hologram94/3DOF-RoboticArm-SPG30E/GUI using keuwlsoft app/readme.txt

1. Install the apk
2. Import the Training_GUI.kwl into the app
3. Connect to the device through bluetooth or USB.
4. Run the GUI panel.
