hologram94/3DOF-RoboticArm-SPG30E/SPG30E Motor References/README_Motor.md

###### Refences for SPG30E Motor

### Description
The motors that were used was obtained from cytron.io. The motor dimensions can be used as a refence if anyone want to tweak the design.
https://my.cytron.io/p-12v-75rpm-3kgfcm-brushed-dc-geared-motor-with-encoder
