hologram94/3DOF-RoboticArm-SPG30E/Calculation/ROBOTIC PROJECT CALCULATION.pdf

D-H PARAMETERS TABLE

FORWARD KINEMATIC

To get the forward kinematic solution, Denavit-Hartenberg (D-H) representation is applied. The D-H model of representation is a very simple way of modeling robot links and joints that any robot configuration such as articulated robot configuration that proposed in this project, regardless of its sequence or complexity. To model the robot with the D-H representation, initially assign a local reference frame for each and every joint. Then determine the following parameters :

- θ , represented a rotation about z-axis.
- d , represented the distance on the z-axis between two successive common normal,
- a , represented the length of each common normal, also defined as length of a link,
joint | αi | i a | i d | θi
1 | 90o | 0 | L1 | θ1
2 | 0o | 0 | 0 | θ2
3 | 0o | L2 | 0 | θ3
4 | 0o | L3 | 0 | 0

- α , represented the angle between two successive z
axes, also defined as joint twist angle.

Transformation nTn+1 between two successive frames representing the preceding four movement is the product of four basic homogeneous transformation matrices (revolute joints) representing them. The final formula of revolute joints is as shown below:

The final formula of revolution matrix

−

−
= −
0 | 0 | 0 | 1

0

1

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

i
α | α
θ | θ α | θ α θ
θ | θ α | θ α | θ

Substitute the parameters in D-H Table into the matrix form above to get the matrices for , , , . ³
4

2
3

1
2

0
1

T T T T

Homogeneous transform matrices

− =

0 0 0 1

0 1 0

0 | 0
0 | 0

1

0

| 1
1 | 1
1 | 1

L

s | c
c | s
T

- −

=
0 | 0 0 1
0 | 0 1 0 0 0 0 0

2

1 | 2 | 2
2 | 2
s | c
c | s
T

- −

=
0 0 0 1

0 0 1 0

0

0

3

2 | 3 | 3 | 2 3
3 | 3 | 2 3
| s | c | L s
c | s | L c
T

=
0 0 0 1

0 0 1 0

0 1 0 0

1 0 0

4

3

L3
T

Where i c is the cosine of the angleθi , and i s represent the sine.

By multiplying the homogeneous transformation matrices in the right order, T

0
4
describing the end-effector frame with the reference frame may be obtained.

T T T T T

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
− | + | + | +
− | − | − | − | + | − | −
− | − | − | + | − | −

=
0 | 0 | 0 | 1
23 23 | 23 | 23 | 0 | 2 3 3 | 2 3 2 | 3 2 3 | 1
1 23 | 1 23 | 2 13 | 3 12 | 1 | 1 23 2 | 1 23 3 | 1 23 2 | 1 23 3
1 23 | 1 23 | 12 3 | 13 2 | 1 | 1 23 2 | 1 23 3 | 1 23 2 | 1 23 3

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

INVERSE KINEMATIC

=
0 0 0 1

0
M N B z

M N B y

M N B x
T
y | y | y
y | y | y
x | x | x
H | (1-2)

By comparing Eq. (1-1) anf Eq. (1-2)

2 3 3 | 2 3 2 | 3 2 3 | 1
1 23 2 | 1 23 3 | 1 23 2 | 1 23 3
1 23 2 | 1 23 3 | 1 23 2 | 1 23 3

z c s L c s L c s L L

y s c L s c L s s L s s L

x c c L c c L c s L c s L

= | + | + | +
= | + | − | −
= | + | − | −
(Assumed)
( | )
( | )

1
1

1

1 23 2 | 23 3 | 23 2 | 23 3
1 23 2 | 23 3 | 23 2 | 23 3
1 23 2 | 1 23 3 | 1 23 2 | 1 23 3
1 23 2 | 1 23 3 | 1 23 2 | 1 23 3

= = tanθ

+ | − | −
+ | − | − =
+ | − | −
+ | − | − =

c

s

c c L c L s L s L

s c L c L s L s L

c c L c c L c s L c s L

s c L s c L s s L s s L
x

y

- = | x
y θ1 | a tan 2 | (1-3)

23
23

23 = = tanθ
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
θ 23 | a tan 2 | (1-4)

3 3

2 3 3 | 2 3 2 | 1
2
2 3 3 | 2 3 2 | 3 2 3 | 1

c L

z c s L c s L L
s

z c s L c s L c s L L

− | − | − =
= | + | + | +
(1-5)
( | ) 1 23 2 | 23 3 | 23 2 | 23 3
1 23 2 | 1 23 3 | 1 23 2 | 1 23 3

x c c L c L s L s L

x c c L c c L c s L c s L

= | + | − | −
= | + | − | −
3 2 | 3 3
23 2 | 23 3
1
2
c L c L

s L s L
c

x
c
+
+ | +
= | (1-6)

From Eq. (1-5) and Eq. (1-6)

+

+ | +
− | − | −
=

−

− | −
= | =
3 2 | 3 3
23 2 | 23 3
1

3 3

2 3 3 | 2 3 2 | 1

2

2

23 3
1

2

23 3 1

2
2

2

tan 2

tan

c L c L

s L s L
c

x

c L

z c s L c s L L
a

L

c L
c

x

L

z s L L

c

s

θ

θ

From Eq. assumed

Summing up squares of x y z

( | ) ( | )

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
2 | 2 | 2
3 | 2

2
L L
x y z | L L | L | L z L
c
+ + − | + | + | − | − = | (1-7)

From pythagorean trigonometric

3 | 1 3 s = ± − c | (1-8)

From Eq. (1-7) and Eq. (1-8)

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
tan 2

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
