hologram94/3DOF-RoboticArm-SPG30E/GUI using keuwlsoft app/GUI_Screenshot.jpg

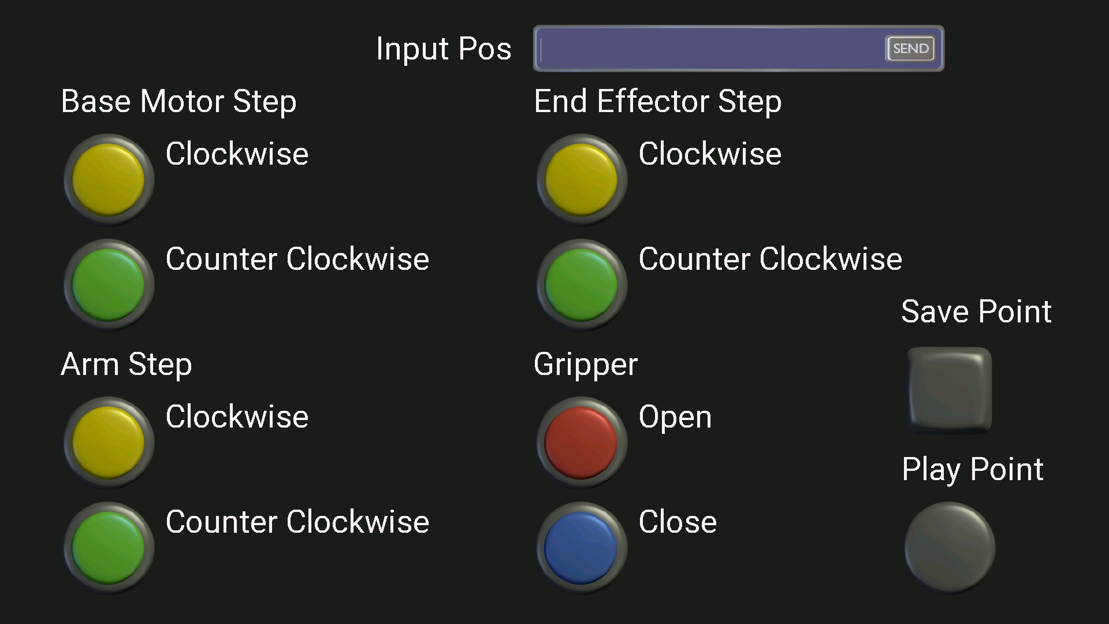
GUI using keuwlsoft app/GUI_Screenshot.jpg
