hologram94/3DOF-RoboticArm-SPG30E/Servo Gripper STL and Coding/stl/Mount.stl

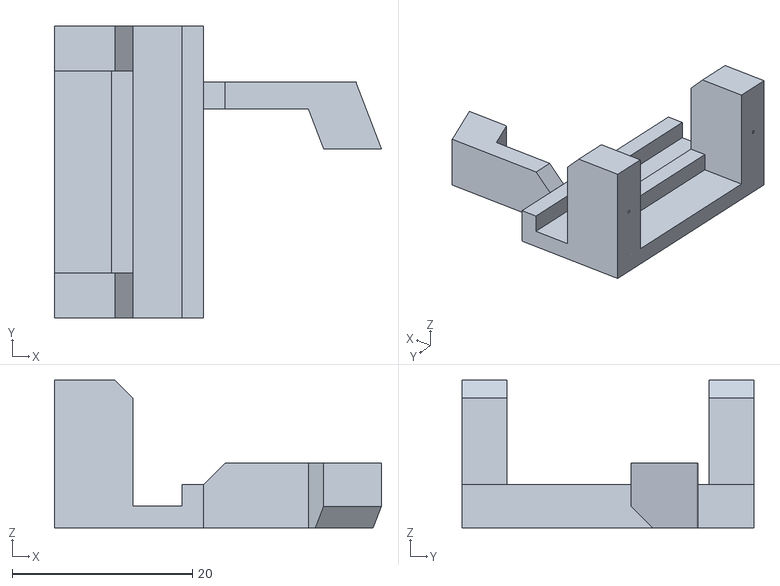
[picture p3: CAD file, 2019-12-25]
Servo Gripper STL and Coding/stl/Mount.stl
36.3 x 32.4 x 16.4
