hologram94/3DOF-RoboticArm-SPG30E/STL Files and Drawing/Arm/Arm.stl

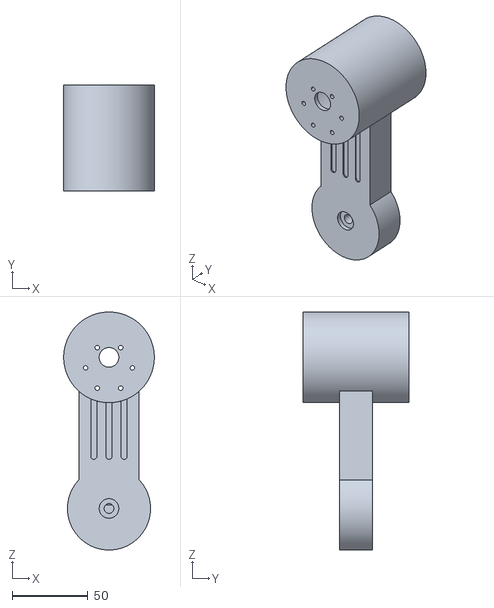
[picture p4: CAD file, 2019-12-24]
STL Files and Drawing/Arm/Arm.stl
60.0 x 70.0 x 157.5
