hologram94/3DOF-RoboticArm-SPG30E/STL Files and Drawing/Base Arm/Base_Arm.stl

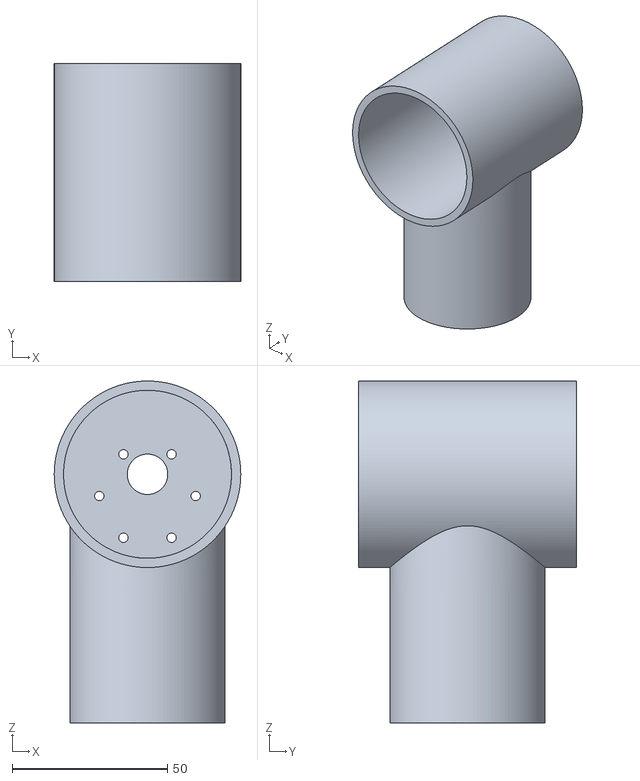
[picture p5: CAD file, 2019-12-24]
STL Files and Drawing/Base Arm/Base_Arm.stl
60.0 x 70.0 x 110.0
