hologram94/3DOF-RoboticArm-SPG30E/STL Files and Drawing/Base/Base.stl

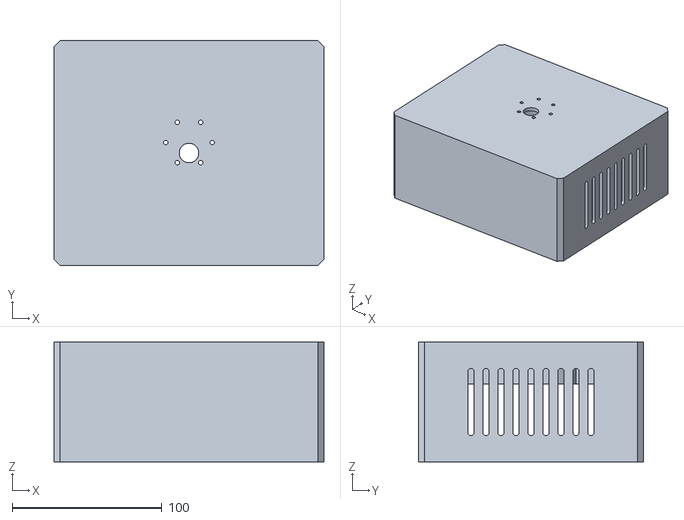
[picture p6: CAD file, 2019-12-24]
STL Files and Drawing/Base/Base.stl
180.0 x 150.0 x 80.0
