hologram94/3DOF-RoboticArm-SPG30E/STL Files and Drawing/Cap/Cap.stl

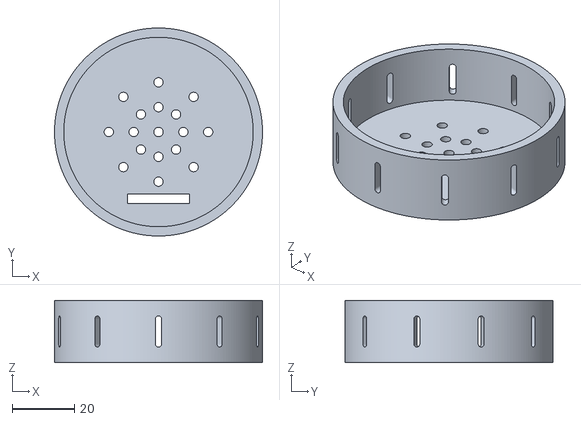
[picture p7: CAD file, 2019-12-24]
STL Files and Drawing/Cap/Cap.stl
67.0 x 67.0 x 20.0
