hologram94/3DOF-RoboticArm-SPG30E/STL Files and Drawing/End Effector/End_Effector.stl

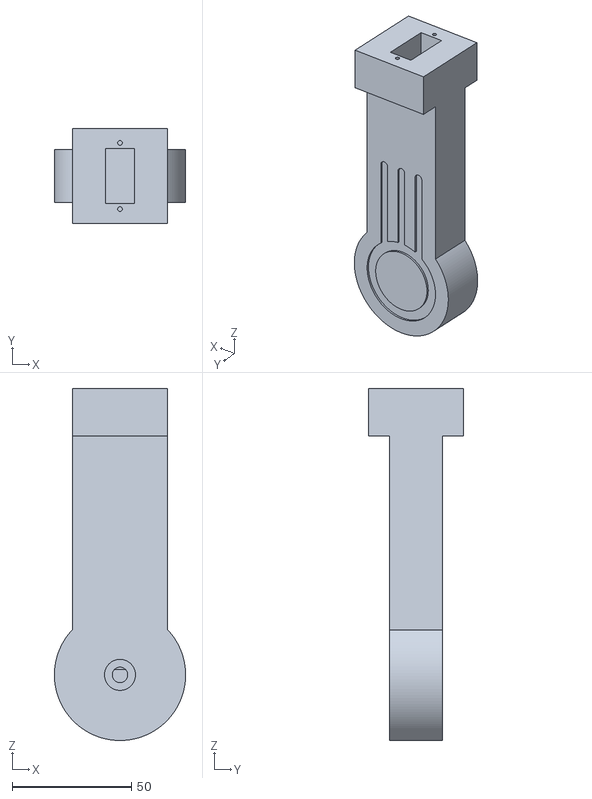
[picture p8: CAD file, 2019-12-24]
STL Files and Drawing/End Effector/End_Effector.stl
55.0 x 40.0 x 147.5
