hologram94/3DOF-RoboticArm-SPG30E/Servo Gripper STL and Coding/stl/Arm.stl

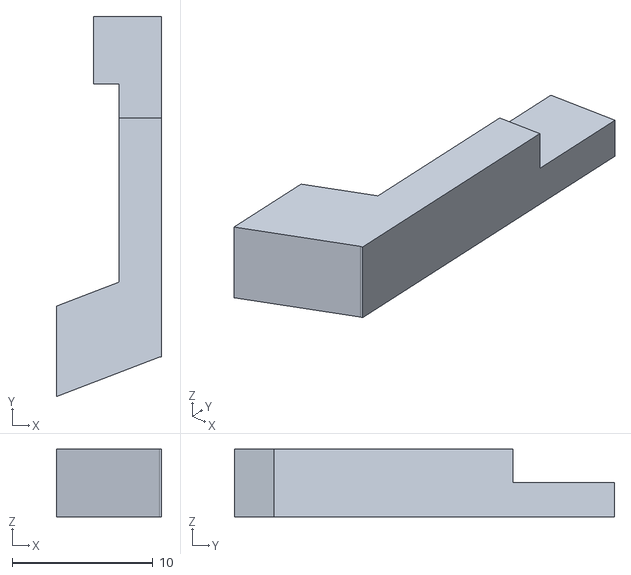
[picture p9: CAD file, 2019-12-25]
Servo Gripper STL and Coding/stl/Arm.stl
7.43 x 27.0 x 4.81
