hologram94/3DOF-RoboticArm-SPG30E/Servo Gripper STL and Coding/stl/Linear_gear.stl

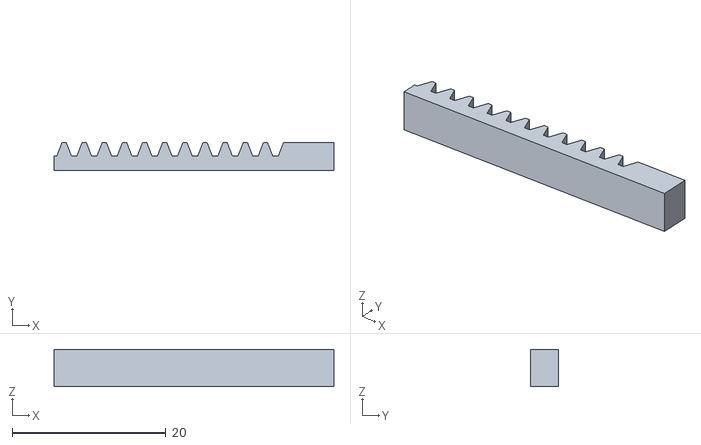
[picture p10: CAD file, 2019-12-25]
Servo Gripper STL and Coding/stl/Linear_gear.stl
36.5 x 3.68 x 4.84
