hologram94/3DOF-RoboticArm-SPG30E/Servo Gripper STL and Coding/stl/Round_gear.stl

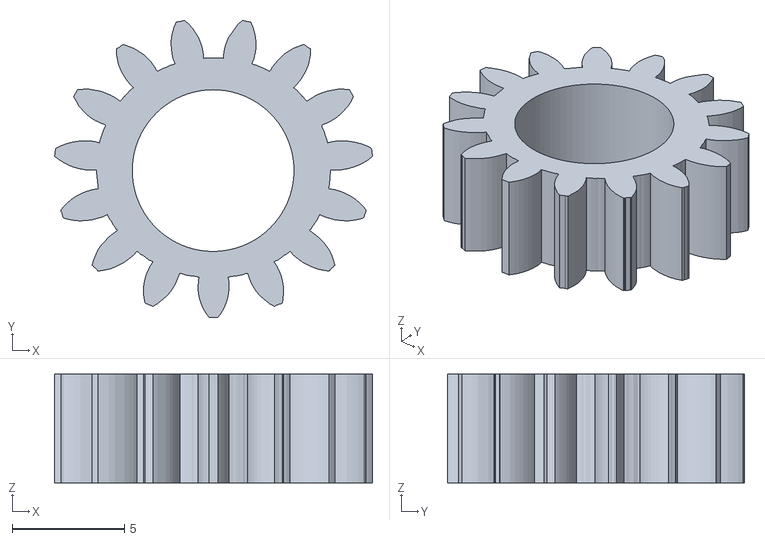
[picture p11: CAD file, 2019-12-25]
Servo Gripper STL and Coding/stl/Round_gear.stl
14.2 x 13.2 x 4.84
