hologram94/3DOF-RoboticArm-SPG30E/STL Files and Drawing/Arm/Arm Drawing v5.pdf

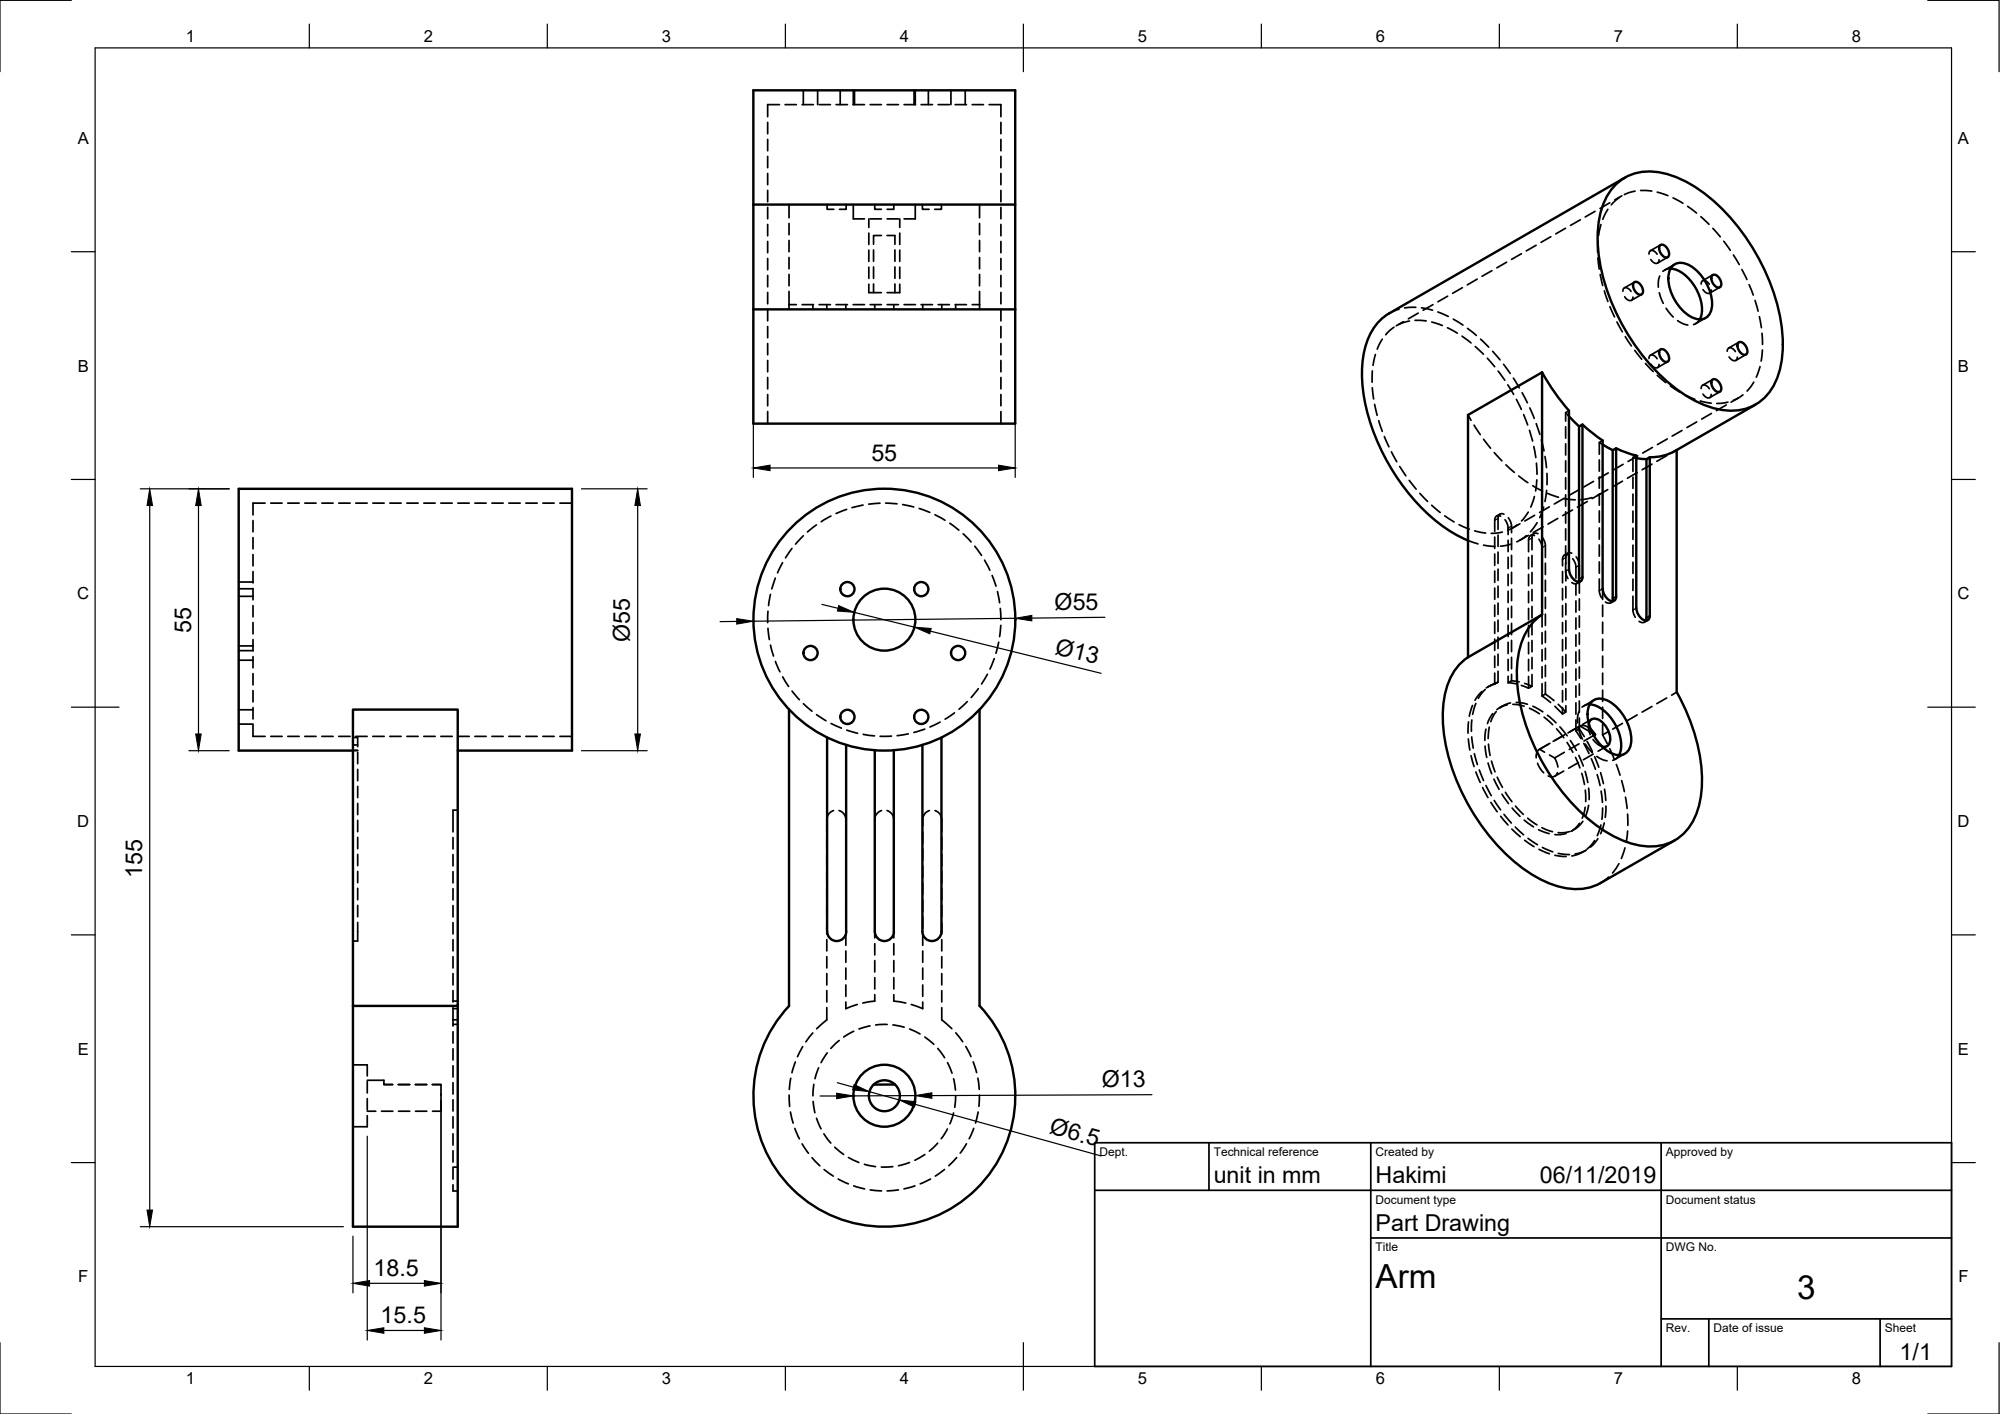
[picture p12: page 1]
unit in mm; Hakimi 155

Dept. | Technical reference | Created by 06/11/2019 | Approved by

Document type Part Drawing | Document status

Title | DWG No. 3 Arm

Rev. | Date of issue | Sheet 1/1
