hologram94/3DOF-RoboticArm-SPG30E/STL Files and Drawing/Base/Base 15cm x 18cm Drawing v1.pdf

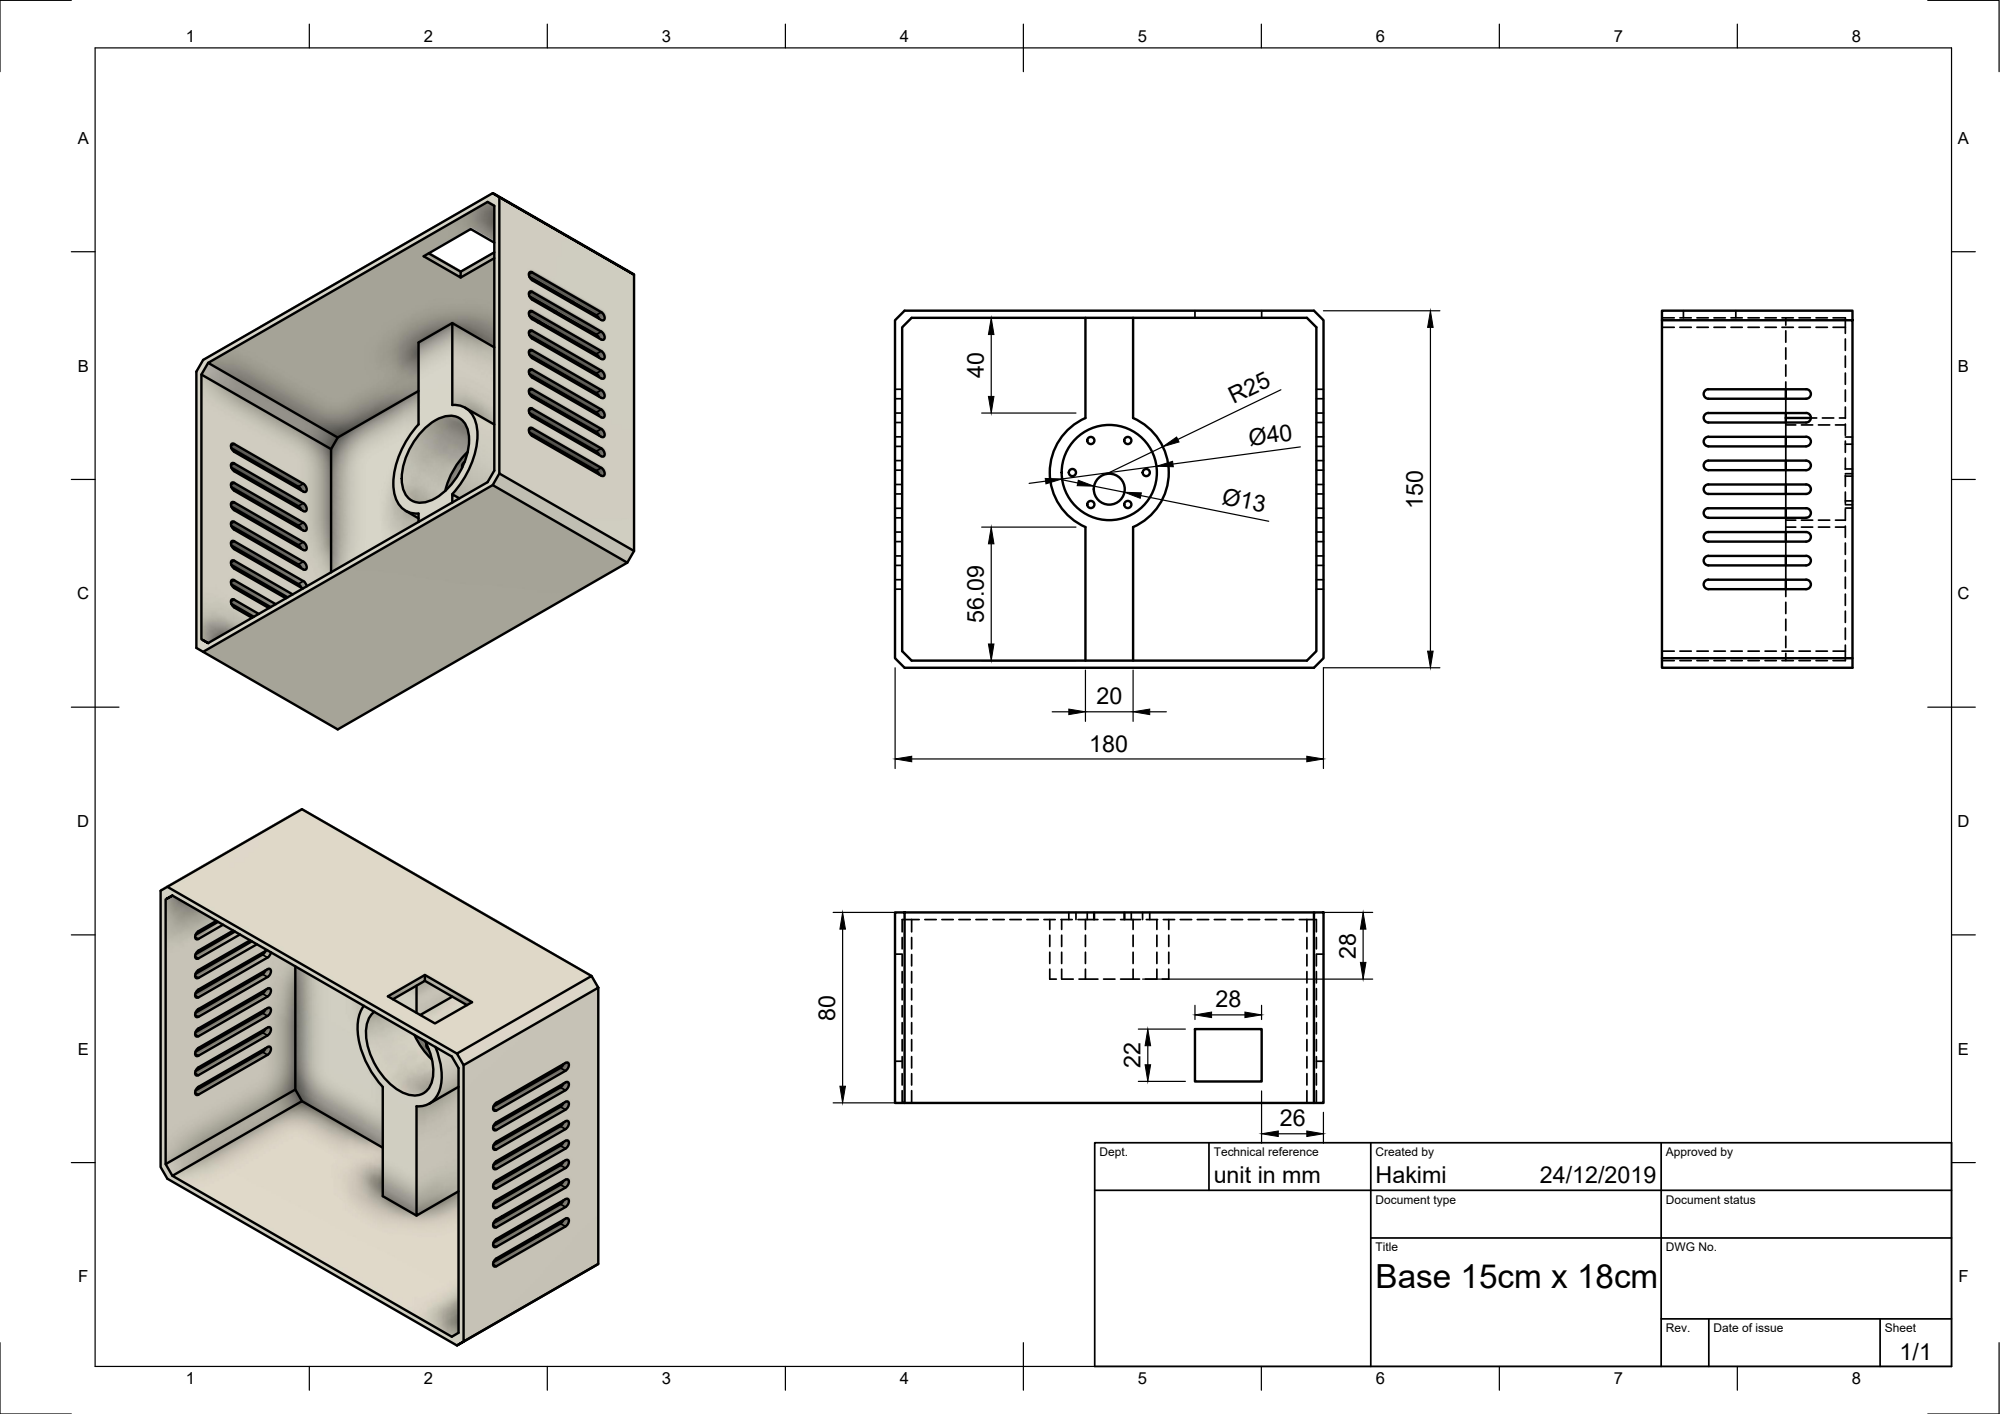
[picture p13: page 1]

Dept. | Technical reference unit in mm | Created by Hakimi 24/12/2019 | Approved by

Document type | Document status

Title Base 15cm x 18cm | DWG No.

Rev. | Date of issue | Sheet 1/1
