hologram94/3DOF-RoboticArm-SPG30E/STL Files and Drawing/Base Arm/Base_Arm Drawing v4.pdf

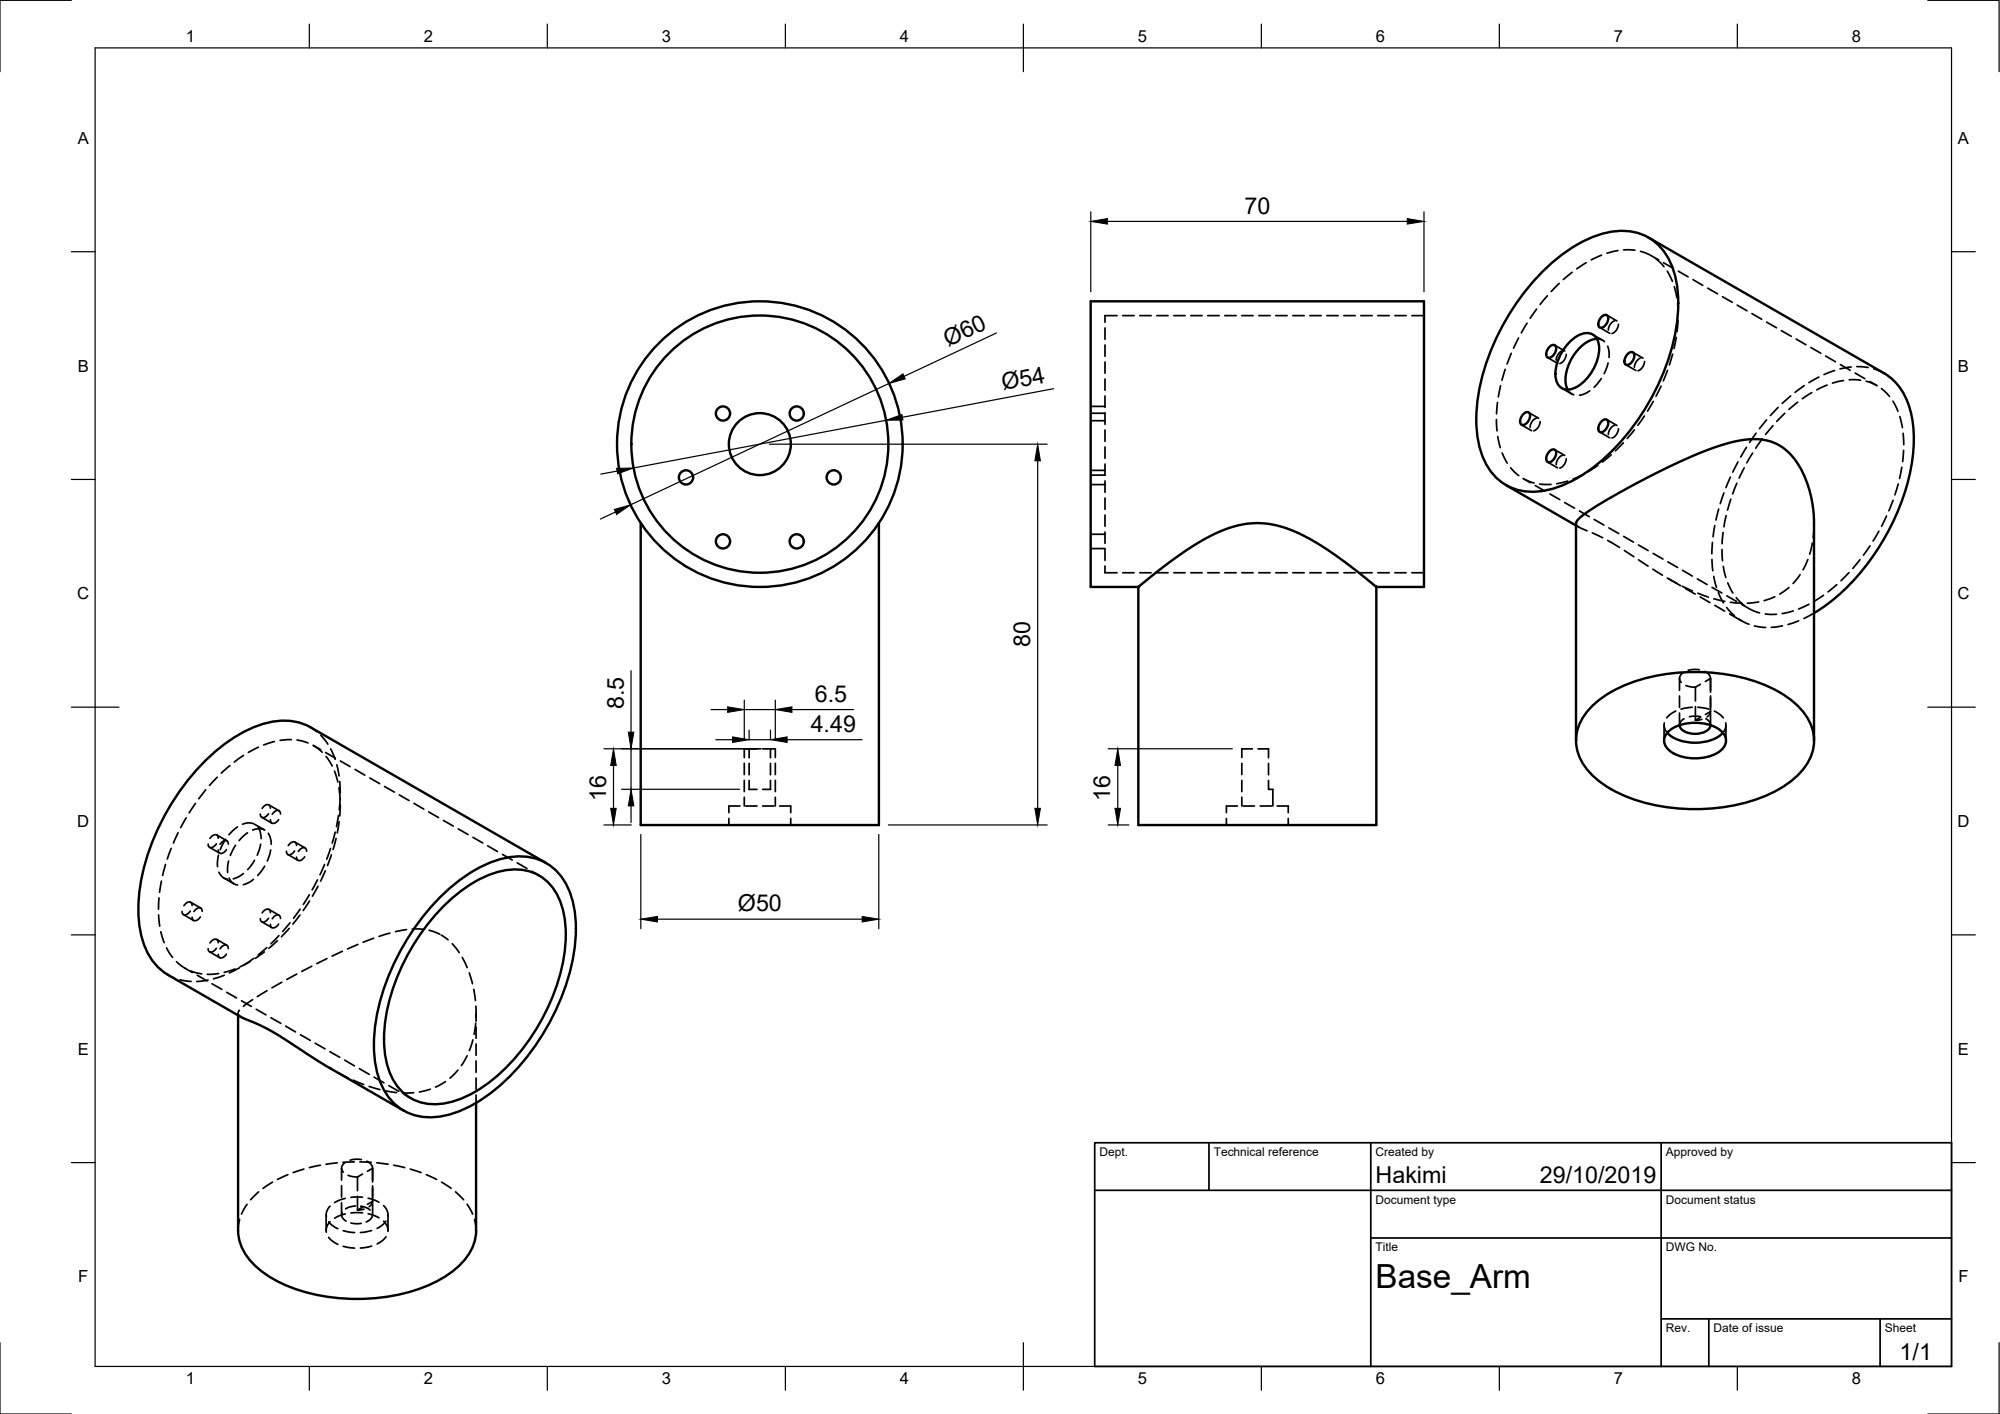
[picture p14: page 1]

Dept. | Technical reference | Created by Hakimi 29/10/2019 | Approved by

Document type | Document status

Title Base_Arm | DWG No.

Rev. | Date of issue | Sheet 1/1
