hologram94/3DOF-RoboticArm-SPG30E/STL Files and Drawing/Cap/Cap Drawing v4.pdf

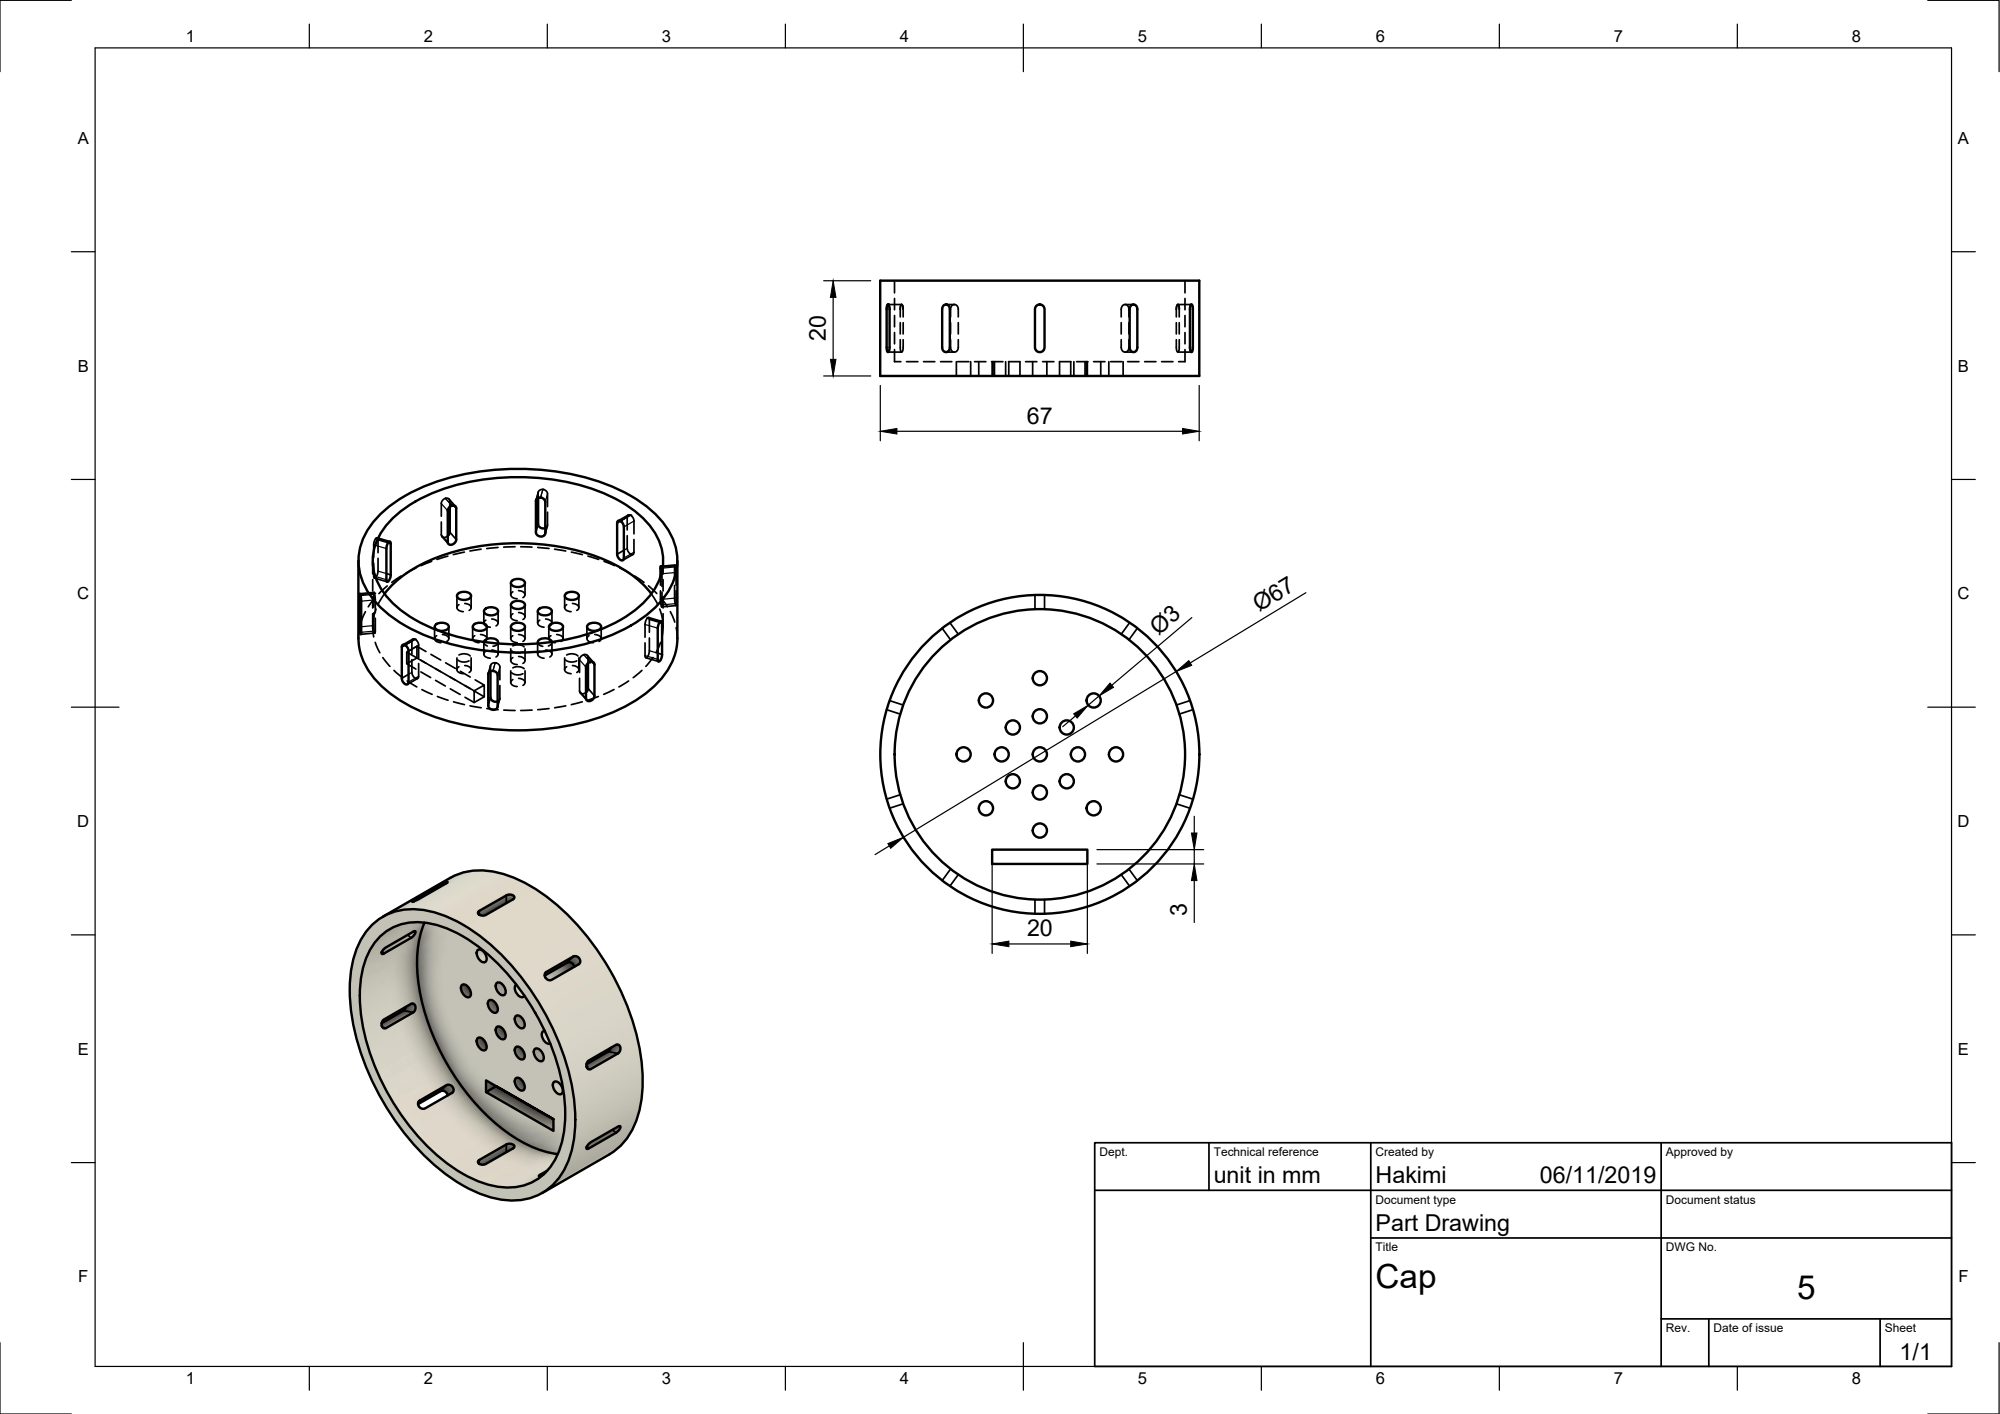
[picture p15: page 1]
unit in mm; Hakimi 20

Dept. | Technical reference | Created by 06/11/2019 | Approved by

Document type Part Drawing | Document status

Title Cap | DWG No. 5

Rev. | Date of issue | Sheet 1/1
