hologram94/3DOF-RoboticArm-SPG30E/STL Files and Drawing/End Effector/End Effector Drawing v1.pdf

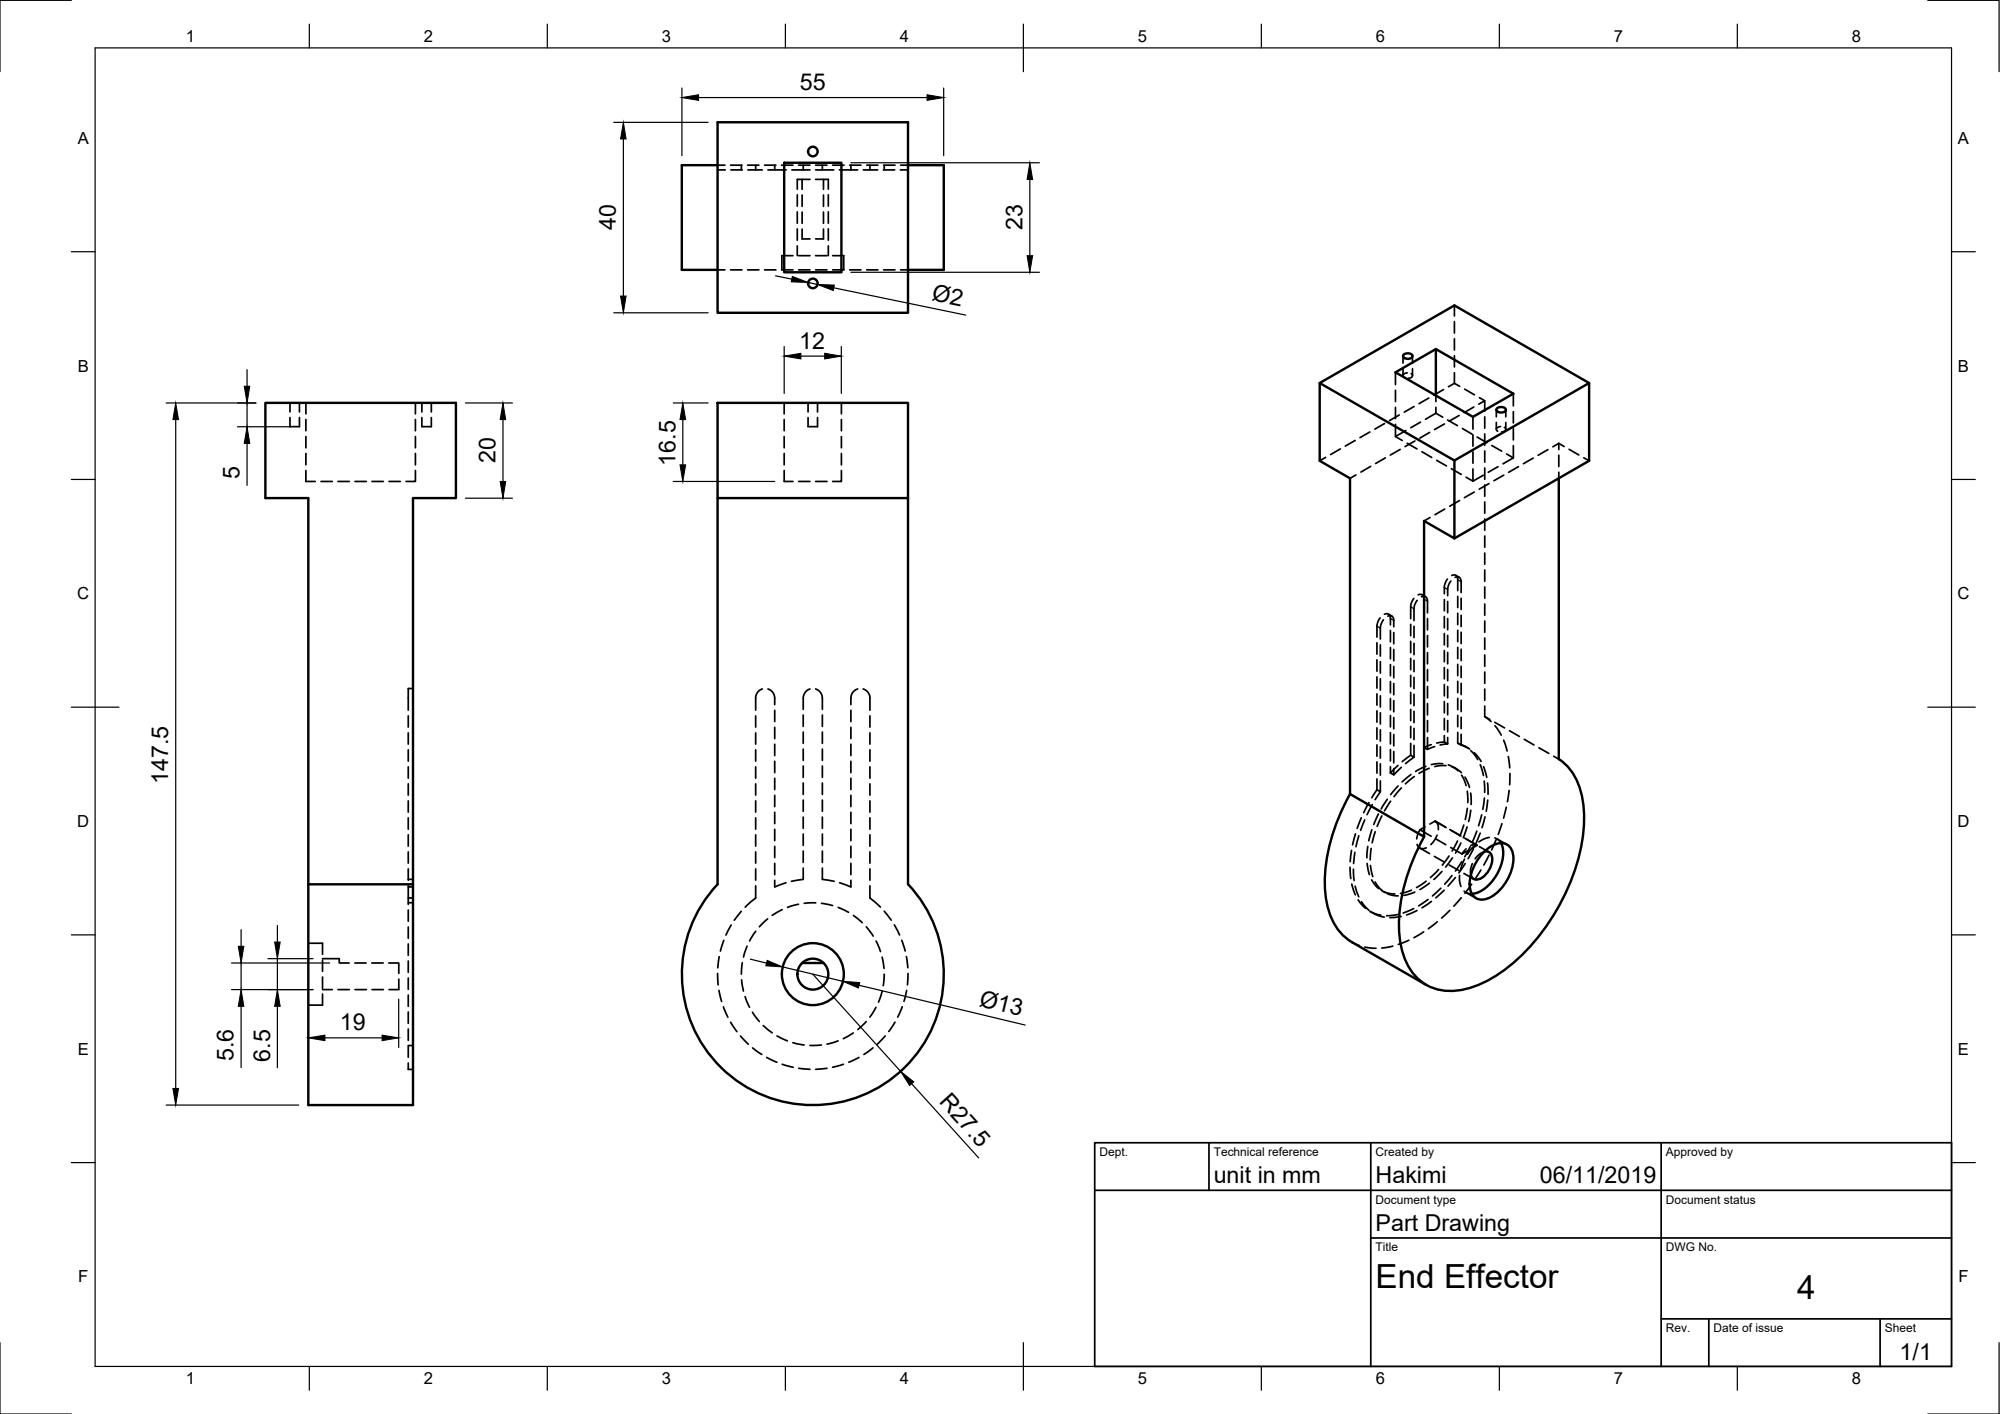
[picture p16: page 1]
unit in mm; Hakimi 147.5

Dept. | Technical reference | Created by 06/11/2019 | Approved by

Document type Part Drawing | Document status

Title | DWG No. 4 End Effector

Rev. | Date of issue | Sheet 1/1
