hologram94/3DOF-RoboticArm-SPG30E/(commit log)

2019-12-24 STL Files & Drawings
    Add STL files for 3D printing and Drawing Dimensions in A3.
    [Arm.stl, Base.stl, Base_Arm.stl, Cap.stl, End_Effector.stl]
2019-12-24 Create Assembly v17.png
2019-12-25 Create Arduino-PID-Library-master.zip
    Adding PID Library for arduino.
2019-12-25 added servo gripper stl and coding
    [Arm.stl, Linear_gear.stl, Mount.stl, Round_gear.stl]
2019-12-25 Matlab Simulation (forward kinematic)
2019-12-25 forward and inverse kinematic calculation
2020-01-13 Motor Dimensions Reference
    SPG30E motor Dimensions and website to purchase
2020-01-13 SPG30E PID Coding for single motor
    Arduino Coding for SPG30E.
2020-01-13 Servo Gripper and Coding
